rscott2049/T-11-with-RP2350/brd/pico2-t11_rev_1.0a.pdf

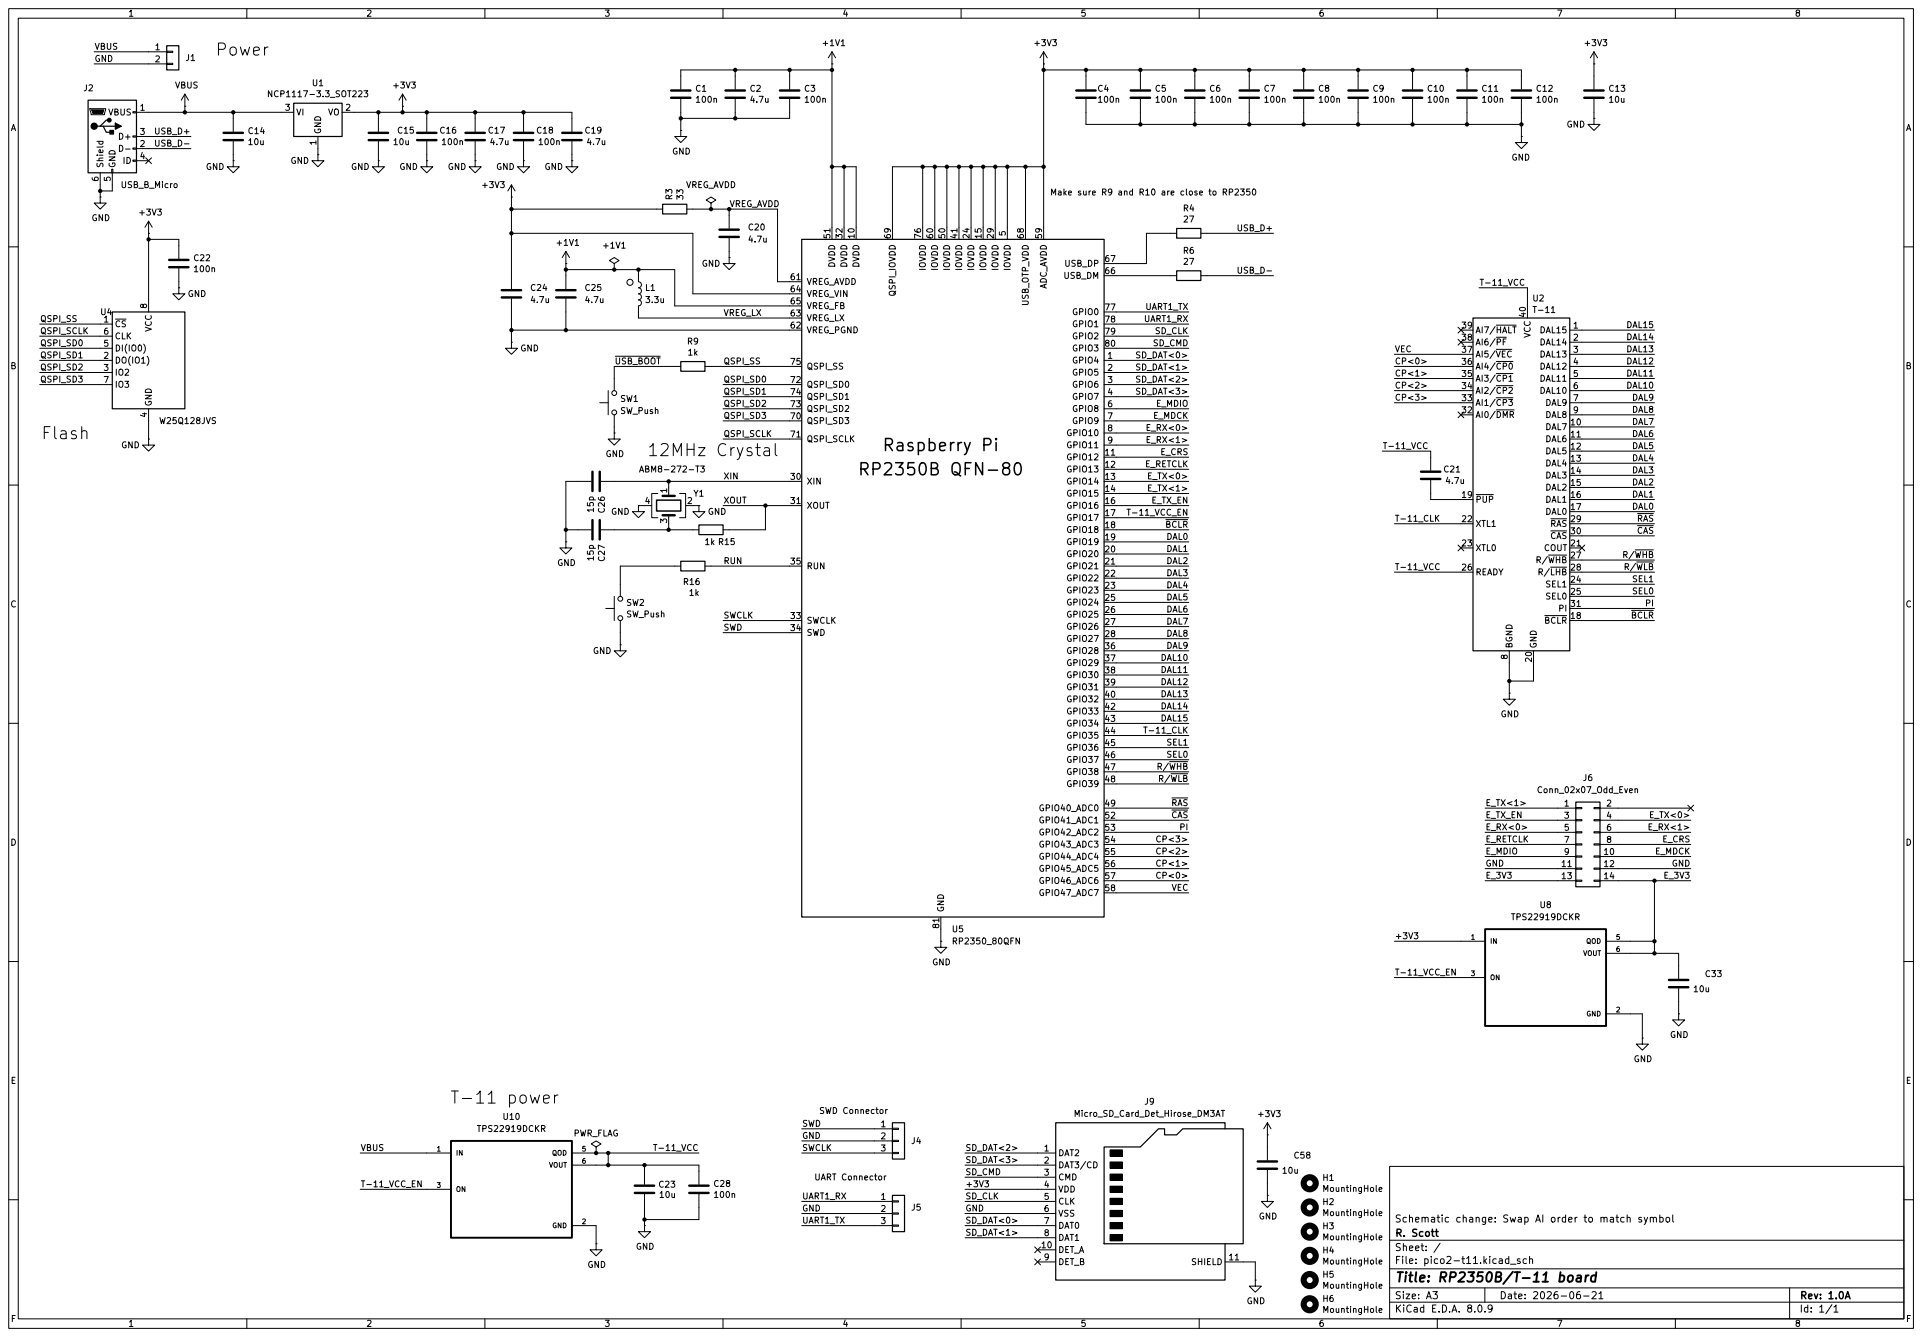
[picture p4: page 1]
