rscott2049/T-11-with-RP2350/sw/initial_test_v1.0/src/m9312.h

/**
 * @file m9312_23_248F1.h
 * @brief DEC M9312 ASCII Console & Diagnostics ROM (23-248F1)
 * 
 * Target Systems: PDP-11/04, PDP-11/05, PDP-11/34, PDP-11/40, PDP-11/45
 * UNIBUS Address Range: 17773000 - 17773776 (Octal 773000 - 773776)
 * Size: 256 Words (512 Bytes)
 */

#ifndef M9312_23_248F1_H
#define M9312_23_248F1_H

/* Array matching the 23-248F1 binary ROM dump */
// used as starting point:
// srec_cat 23-248F1-1983.hex -Intel -Output tmp.h -C-Array rom

/* http://srecord.sourceforge.net/ */
#define M9312_ROM_LEN 1024
static const uint8_t m9312_rom_23_248F1[M9312_ROM_LEN] = {
0x00, 0x00, 0x06, 0x0F, 0x00, 0x00, 0x06, 0x0F, 0x00, 0x00, 0x0C, 0x09,
0x0F, 0x0F, 0x03, 0x0E, 0x06, 0x00, 0x06, 0x0F, 0x06, 0x00, 0x06, 0x0F,
0x01, 0x04, 0x0C, 0x01, 0x01, 0x04, 0x0D, 0x01, 0x02, 0x00, 0x07, 0x01,
0x02, 0x08, 0x07, 0x01, 0x02, 0x04, 0x07, 0x01, 0x02, 0x08, 0x01, 0x01,
0x02, 0x0C, 0x01, 0x01, 0x02, 0x00, 0x01, 0x01, 0x03, 0x0C, 0x07, 0x01,
0x03, 0x00, 0x07, 0x01, 0x02, 0x0C, 0x07, 0x01, 0x03, 0x08, 0x07, 0x01,
0x02, 0x04, 0x01, 0x01, 0x03, 0x04, 0x07, 0x01, 0x02, 0x0C, 0x0D, 0x01,
0x0E, 0x0F, 0x0F, 0x01, 0x03, 0x0C, 0x08, 0x00, 0x00, 0x00, 0x06, 0x0F,
0x02, 0x08, 0x0F, 0x00, 0x02, 0x08, 0x09, 0x03, 0x0E, 0x0F, 0x0F, 0x01,
0x02, 0x08, 0x0B, 0x07, 0x02, 0x08, 0x07, 0x0F, 0x02, 0x08, 0x05, 0x05,
0x02, 0x08, 0x01, 0x04, 0x0A, 0x00, 0x0C, 0x01, 0x02, 0x08, 0x03, 0x02,
0x0A, 0x00, 0x0C, 0x01, 0x0F, 0x0F, 0x0F, 0x01, 0x03, 0x0C, 0x0D, 0x00,
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
  /* 060-077 */ 012710, 000002, 010570, 010036, 005710, 010015, 012700, 0177344,
  /* 100-117 */ 006010, 001402, 000005, 012700, 0177412, 012710, 000005, 010570,
  /* 120-137 */ 010036, 005710, 010002, 005003, 000207, 011010, 000207, 000613
};

/**
 * @brief Multi-ROM Unibus address mapping helper function.
 * 
 * @param address Current read address from the simulated Unibus.
 * @param base_offset The base configuration offset chosen for this ROM socket (e.g. 0173000, 0173200)
 * @param target_rom Choice of pointer matching m9312_rom_23_755a9 or m9312_rom_23_756a9.
 * @param word_out Decoded word destination if validation checks match.
 * @return int 1 on valid intercept, 0 if out of slot boundaries.
 */
static inline int m9312_read_boot_word(uint32_t address, uint32_t base_offset, 
                                       const uint16_t *target_rom, uint16_t *word_out) {
    uint32_t io_offset = address & 0xFFFF;
    
    if (io_offset >= base_offset && io_offset < (base_offset + M9312_BOOT_BYTES)) {
        uint32_t index = (io_offset - base_offset) >> 1;
        if (index < M9312_BOOT_WORDS) {
            *word_out = target_rom[index];
            return 1;
        }
    }
    return 0;
}

#endif /* M9312_BOOT_PROMS_H */

#endif /* M9312_23_248F1_H */
