rscott2049/T-11-with-RP2350/sw/initial_test_v1.0/src/lda_file.h

unsigned char data[] = {0x01, 0x00, 0x7A, 0x04, 0x00, 0x00, 0x77, 0x00, 0xFC, 0x00, 0xE6, 0x01, 0xE0, 0x00, 0x00, 0x00, 0x00, 0x00, 0x00, 0x00, 0x00, 0x00, 0x00, 0x00, 0x00, 0x00, 0x00, 0x00, 0x00, 0x00, 0x00, 0x00, 0x00, 0x00, 0x00, 0x00, 0x00, 0x00, 0x00, 0x00, 0x00, 0x00, 0x00, 0x00, 0x00, 0x00, 0x00, 0x00, 0x00, 0x00, 0x00, 0x00, 0x00, 0x00, 0x62, 0x01, 0xE0, 0x00, 0x96, 0x01, 0xE0, 0x00, 0xB2, 0x01, 0xE0, 0x00, 0x00, 0x00, 0x00, 0x00, 0xB2, 0x01, 0xE2, 0x00, 0x00, 0x00, 0x00, 0x00, 0x00, 0x00, 0x00, 0x00, 0xB2, 0x01, 0xE0, 0x00, 0x00, 0x00, 0x00, 0x00, 0x00, 0x00, 0x00, 0x00, 0x00, 0x00, 0x00, 0x00, 0xB2, 0x01, 0xE0, 0x00, 0x00, 0x00, 0x00, 0x00, 0x00, 0x00, 0x00, 0x00, 0x00, 0x00, 0x00, 0x00, 0x00, 0x00, 0x00, 0x00, 0x00, 0x00, 0x00, 0x00, 0x00, 0x00, 0x00, 0x00, 0x00, 0x00, 0x00, 0x00, 0x00, 0x00, 0x00, 0x00, 0xB6, 0x01, 0xE0, 0x00, 0x00, 0x00, 0x00, 0x00, 0x00, 0x00, 0x00, 0x00, 0x00, 0x00, 0x00, 0x00, 0x00, 0x00, 0x00, 0x00, 0x00, 0x00, 0x00, 0x00, 0x00, 0x00, 0x00, 0x00, 0x00, 0x00, 0x00, 0x00, 0x00, 0x00, 0x00, 0x00, 0x00, 0x00, 0x00, 0x00, 0x00, 0x00, 0x00, 0x00, 0x00, 0x00, 0x00, 0x00, 0x00, 0x00, 0x00, 0x00, 0x00, 0x00, 0x00, 0x00, 0x00, 0x00, 0x00, 0x00, 0x00, 0x00, 0x00, 0x00, 0xB2, 0x01, 0xE1, 0x00, 0x00, 0x00, 0x00, 0x00, 0x00, 0x00, 0x00, 0x00, 0x00, 0x00, 0x00, 0x00, 0x00, 0x00, 0x00, 0x00, 0x00, 0x00, 0x00, 0x00, 0x00, 0x00, 0x00, 0x00, 0x00, 0x00, 0x00, 0x00, 0x00, 0x00, 0x00, 0x00, 0x00, 0x00, 0x00, 0x00, 0x00, 0x00, 0x00, 0x00, 0x00, 0x00, 0x00, 0x00, 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
0x00, 0x00, 0x00, 0x00, 0x00, 0x00, 0x00, 0x00, 0x00, 0x00, 0x00, 0x00, 0x00, 0x00, 0x00, 0x00, 0x00, 0x00, 0x00, 0x00, 0x00, 0x00, 0x00, 0x00, 0x00, 0x00, 0x00, 0x00, 0x00, 0x00, 0x00, 0x00, 0x00, 0x00, 0x00, 0x00, 0xC6, 0x15, 0x00, 0x04, 0xC0, 0x15, 0x00, 0x00, 0x03, 0x10, 0xC3, 0x00, 0xC1, 0x15, 0x00, 0xF9, 0xF1, 0x15, 0x0B, 0x00, 0x04, 0x00, 0xC3, 0x55, 0x04, 0x00, 0xC9, 0x10, 0xC9, 0x8B, 0xFE, 0x80, 0x42, 0x1C, 0x06, 0x00, 0xC2, 0x45, 0x3F, 0x00, 0x82, 0x0A, 0xB1, 0x10, 0x04, 0x00, 0x03, 0x8A, 0xC3, 0x55, 0x06, 0x00, 0xC9, 0x10, 0xC9, 0x8B, 0xFE, 0x80, 0x31, 0x0A, 0x02, 0x00, 0x31, 0x0A, 0x04, 0x00, 0xF1, 0x15, 0x00, 0xFE, 0x06, 0x00, 0x03, 0x8A, 0xC3, 0x55, 0x0C, 0x00, 0xC9, 0x10, 0xC9, 0x8B, 0xFE, 0x80, 0xC9, 0x45, 0xFF, 0x00, 0x02, 0x0A, 0x03, 0x0A, 0xC4, 0x15, 0x10, 0x04, 0x05, 0x0A, 0x07, 0x0A, 0x00, 0x00, 0xC0, 0x15, 0x00, 0xF9, 0x01, 0x12, 0xC8, 0x15, 0x08, 0x00, 0x00, 0x00, 0x4A, 0x01, 0x00, 0x06, 0x00, 0x00, 0x00, 0xF9};
unsigned int data_size = 1154U;
