rscott2049/T-11-with-RP2350/sw/initial_test_v1.0/src/boot_rom.h

unsigned char boot_rom[] = {0x01, 0x00, 0x56, 0x00, 0x00, 0xF6, 0x5F, 0x00, 0x00, 0x00, 0x37, 0x10, 0x34, 0x00, 0x80, 0x13, 0xF0, 0x0B, 0xFE, 0xFF, 0x04, 0x03, 0xC0, 0x1D, 0x28, 0x00, 0xC7, 0x17, 0x04, 0x00, 0xC0, 0x15, 0x3E, 0xF6, 0xF7, 0x09, 0x0A, 0x00, 0x80, 0x13, 0xC1, 0x15, 0x64, 0xEA, 0x5F, 0x00, 0x18, 0xEB, 0xC1, 0x15, 0x74, 0xFF, 0x31, 0x94, 0x02, 0x00, 0xC9, 0x8B, 0xFE, 0x80, 0xC8, 0x8B, 0xFA, 0x02, 0x87, 0x00, 0x00, 0x00, 0x48, 0x41, 0x4C, 0x54, 0x45, 0x44, 0x2E, 0x20, 0x4E, 0x65, 0x78, 0x74, 0x20, 0x50, 0x43, 0x3A, 0x20, 0x00, 0xD0, 0x01, 0x00, 0x06, 0x00, 0x00, 0xF6, 0x03};
unsigned int boot_rom_size = 94U;
