rscott2049/T-11-with-RP2350/sw/initial_test_v1.0/src/m9312_console_mod.h

#ifndef M9312_CONSOLE_MOD_H
#define M9312_CONSOLE_MOD_H

#include <stdint.h>

const uint16_t m9312_console_mod[] = {
    0165000, 0165000, 0100000, 0177777, 0165006, 0165006, 0000500, 0000501, 
    0005003, 0005203, 0005103, 0006203, 0006303, 0006003, 0005703, 0005403, 
    0005303, 0005603, 0006103, 0005503, 0000303, 0001377, 0012702, 0165000, 
    0011203, 0022203, 0001377, 0063203, 0165203, 0044203, 0056203, 0000012, 
    0037203, 0000012, 0001777, 0010703, 0000123, 0012703, 0165122, 0000133, 
    0000113, 0165120, 0105767, 0177654, 0001377, 0022222, 0105722, 0001377, 
    0105712, 0100377, 0010701, 0000554, 0010701, 0000526, 0010400, 0000524, 
    0010600, 0010701, 0000521, 0010500, 0000517, 0010605, 0010701, 0000540, 
    0112702, 0000100, 0010703, 0000554, 0000240, 0000544, 0000302, 0000542, 
    0020227, 0046040, 0001450, 0020402, 0001001, 0005725, 0010204, 0020227, 
    0042440, 0001446, 0020227, 0042040, 0001432, 0020227, 0051415, 0001002, 
    0000005, 0000115, 0012704, 0173200, 0031427, 0000200, 0001323, 0022402, 
    0001405, 0061404, 0020427, 0173600, 0001731, 0000766, 0010701, 0000423, 
    0000005, 0113705, 0173224, 0106105, 0106105, 0000164, 0000010, 0010701, 
    0000412, 0010015, 0000713, 0010701, 0000406, 0010005, 0005004, 0000706, 
    0010506, 0011505, 0000675, 0005000, 0005002, 0010703, 0000453, 0120227, 
    0000015, 0001433, 0162702, 0000070, 0062702, 0000010, 0103357, 0006300, 
    0006300, 0006300, 0050200, 0000760, 0012702, 0000030, 0000261, 0006100, 
    0106102, 0010703, 0000435, 0012702, 0020206, 0006300, 0001403, 0106102, 
    0103774, 0000765, 0000302, 0010703, 0000423, 0022121, 0000161, 0177776, 
    0012702, 0014012, 0010703, 0000414, 0061702, 0003767, 0105002, 0152702, 
    0000015, 0000770, 0105737, 0177560, 0100375, 0105002, 0153702, 0177562, 
    0105737, 0177564, 0100375, 0110237, 0177566, 0142702, 0100200, 0022323, 
    0000163, 0177776, 0012705, 0165006, 0012702, 0000500, 0011503, 0005012, 
    0112512, 0005202, 0112512, 0005302, 0023512, 0001015, 0005202, 0143522, 
    0024542, 0143522, 0001010, 0010502, 0016505, 0177772, 0110532, 0150572, 
    0000000, 0020352, 0001407, 0000000, 0005723, 0001011, 0021605, 0001007, 
    0000203, 0000000, 0011206, 0012702, 0165650, 0005726, 0004312, 0000000, 
    0004362, 0000004, 0012705, 0160000, 0005037, 0000006, 0012737, 0165722, 
    0000004, 0012706, 0000502, 0005745, 0005003, 0010313, 0005723, 0020305, 
    0101774, 0005003, 0005413, 0060313, 0005723, 0001004, 0020305, 0101772, 
    0000164, 0000002, 0014304, 0010300, 0005006, 0000000, 0040460, 0173417, 
    
};

const unsigned int M9312_CONSOLE_MOD_LEN = 256;

#endif // M9312_CONSOLE_MOD_H
