rscott2049/T-11-with-RP2350/sw/initial_test_v1.0/src/m9312_rom1.h

#ifndef M9312_ROM1_H
#define M9312_ROM1_H

#include <stdint.h>

const uint16_t m9312_rom1[] = {
    0042113, 0000026, 0000261, 0012700, 0000000, 0012701, 0177404, 0010704, 
    0103057, 0000426, 0173000, 0000340, 0042124, 0000146, 0000261, 0012700, 
    0000000, 0012701, 0177342, 0010704, 0103043, 0010003, 0000303, 0010311, 
    0052711, 0004003, 0005711, 0100376, 0005761, 0177776, 0010311, 0000410, 
    0010003, 0000241, 0006003, 0006003, 0006003, 0006003, 0010361, 0000006, 
    0012761, 0177000, 0000002, 0052703, 0000005, 0010311, 0105711, 0100376, 
    0005711, 0100003, 0000005, 0000164, 0000002, 0042711, 0000377, 0005007, 
    0000137, 0165564, 0000261, 0012700, 0000002, 0000707, 0000000, 0124650, 
    0016000, 0016000, 0016000, 0016000, 0016000, 0016000, 0016000, 0016000, 
    0016000, 0016000, 0016000, 0016000, 0016000, 0016000, 0016000, 0016000, 
    0016000, 0016000, 0016000, 0016000, 0016000, 0016000, 0016000, 0016000, 
    0016000, 0016000, 0016000, 0016000, 0016000, 0016000, 0016000, 0016000, 
    0016000, 0016000, 0016000, 0016000, 0016000, 0016000, 0016000, 0016000, 
    0016000, 0016000, 0016000, 0016000, 0016000, 0016000, 0016000, 0016000, 
    0016000, 0016000, 0016000, 0016000, 0016000, 0016000, 0016000, 0016000, 
    0016000, 0016000, 0016000, 0016000, 0016000, 0016000, 0016000, 0016000, 
    
};

const unsigned int M9312_ROM1_LEN = 128;

#endif // M9312_ROM1_H
