rscott2049/T-11-with-RP2350/sw/initial_test_v1.0/src/m9312_rom2.h

#ifndef M9312_ROM2_H
#define M9312_ROM2_H

#include <stdint.h>

const uint16_t m9312_rom2[] = {
    0042114, 0000176, 0000261, 0012700, 0000000, 0012701, 0174400, 0010704, 
    0103064, 0000402, 0173000, 0000340, 0010003, 0000303, 0010311, 0012761, 
    0000013, 0000004, 0052703, 0000004, 0010311, 0105711, 0100376, 0105003, 
    0052703, 0000010, 0010311, 0105711, 0100376, 0016102, 0000006, 0042702, 
    0000077, 0005202, 0010261, 0000004, 0105003, 0052703, 0000006, 0010311, 
    0105711, 0100376, 0005061, 0000004, 0012761, 0177000, 0000006, 0105003, 
    0052703, 0000014, 0010311, 0105711, 0100376, 0005711, 0100003, 0000005, 
    0000164, 0000002, 0042711, 0000377, 0005007, 0000137, 0165564, 0171540, 
    0016000, 0016000, 0016000, 0016000, 0016000, 0016000, 0016000, 0016000, 
    0016000, 0016000, 0016000, 0016000, 0016000, 0016000, 0016000, 0016000, 
    0016000, 0016000, 0016000, 0016000, 0016000, 0016000, 0016000, 0016000, 
    0016000, 0016000, 0016000, 0016000, 0016000, 0016000, 0016000, 0016000, 
    0016000, 0016000, 0016000, 0016000, 0016000, 0016000, 0016000, 0016000, 
    0016000, 0016000, 0016000, 0016000, 0016000, 0016000, 0016000, 0016000, 
    0016000, 0016000, 0016000, 0016000, 0016000, 0016000, 0016000, 0016000, 
    0016000, 0016000, 0016000, 0016000, 0016000, 0016000, 0016000, 0016000, 
    
};

const unsigned int M9312_ROM2_LEN = 128;

#endif // M9312_ROM2_H
